Dharani-Sundharam/SPECTRUM_SIX_SIH2026/geometricsweepfft.jpeg

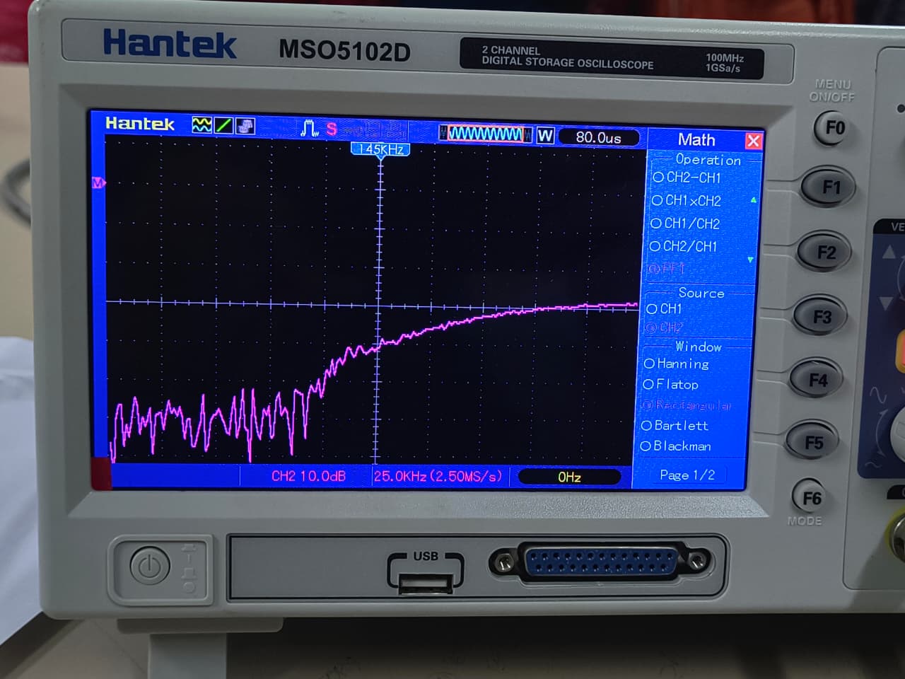
geometricsweepfft.jpeg
