Dharani-Sundharam/SPECTRUM_SIX_SIH2026/lfm_fft.jpeg

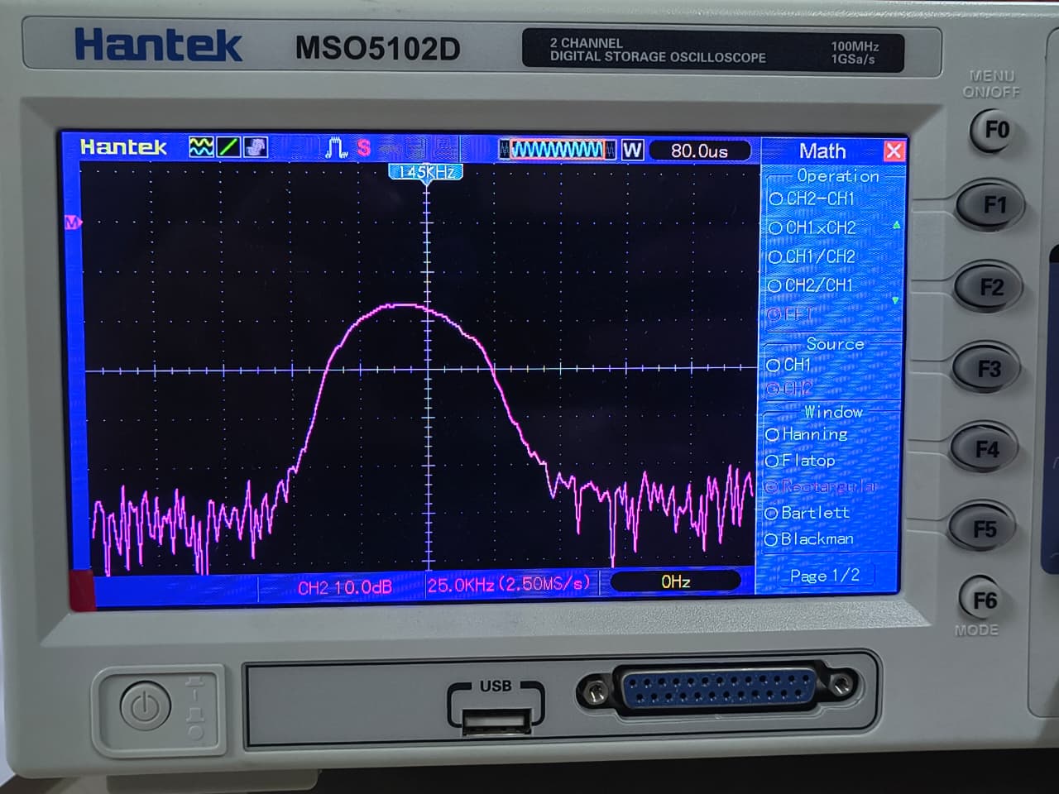
lfm_fft.jpeg
