Dharani-Sundharam/SPECTRUM_SIX_SIH2026/SONAR_CHIRP/SONAR_CHIRP.ioc

Mcu.UserName=STM32F407VETx
PA1.Signal=ADCx_IN1
PA10.Signal=USART1_RX
PA2.Signal=ADCx_IN2
PA3.Signal=ADCx_IN3
PA4.Signal=COMP_DAC1_group
PA9.Signal=USART1_TX
PE4.Signal=GPIO_Input
PH0-OSC_IN.Signal=RCC_OSC_IN
PH1-OSC_OUT.Signal=RCC_OSC_OUT
