Dharani-Sundharam/SPECTRUM_SIX_SIH2026/(notices)

Notices in the files:
README.md:
License: MIT
